AlvaroNegrete/Ivernadero-Automatizado/README.md

# Ivernadero-Automatizado
Código en arduino para un invernadero automatizado enfocado a la hidroponia. Hecho por R.U.N.A
